anagnostoug/EcoFarmBot/final_main_photo.jpg

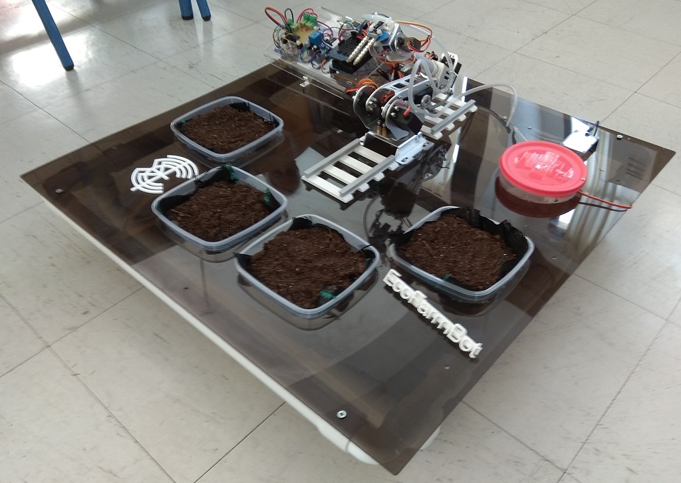
final_main_photo.jpg
