anagnostoug/EcoFarmBot/final_photo_2.jpg

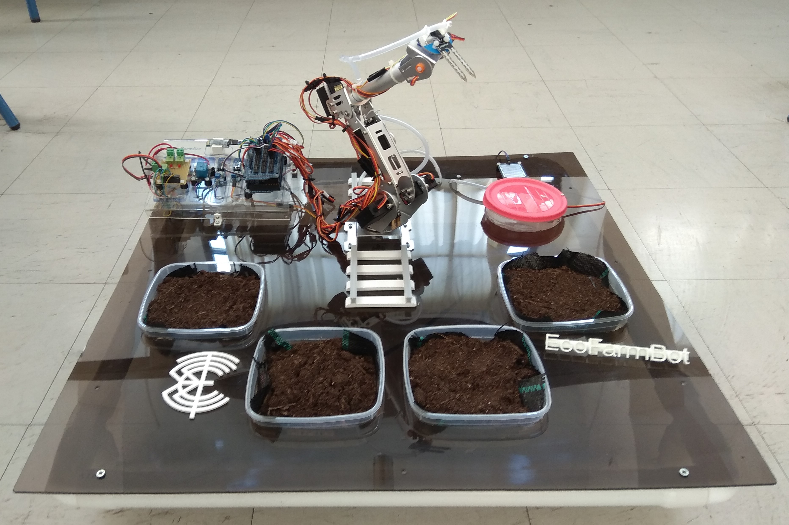
final_photo_2.jpg
