anagnostoug/EcoFarmBot/Φύλλα Έργου/5ο ΦΥΛΛΟ ΕΡΓΟΥ - ΣΥΝΔΕΣΜΟΛΟΓΙΑ.docx

ECO FARM BOT

5ο Φύλλο Έργου - ΣΥΝΔΕΣΜΟΛΟΓΙΑ

Για τη κατασκευή χρησιμοποιούνται τα παρακάτω εξαρτήματα και module:

Α/Α | ΟΝΟΜΑΣΙΑ | ΕΙΚΟΝΑ

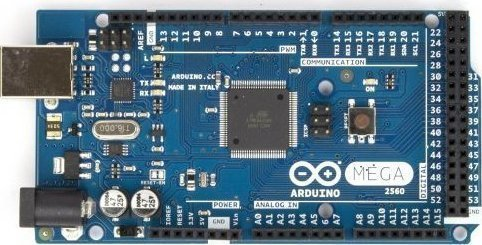
[picture p7: figure]
20150812135726_arduino_mega_2560_rev3

1 | Arduino Mega

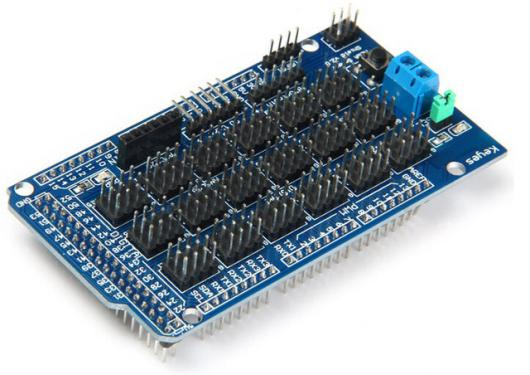
[picture p8: figure]
MEGA-Sensor-Shield-V2-0-Expansion-Board-For-Arduino-ATMEGA-2560-R3

2 | Arduino Mega Shield

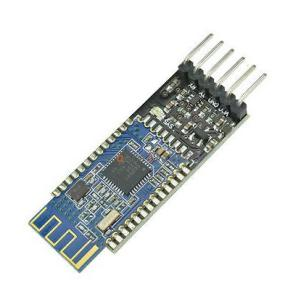
[picture p9: figure]
hm-10-ble-bluetooth-40-cc2540-cc2541-serial-wireless-module-arduino-android-ios

3 | Arduino Bluetooth

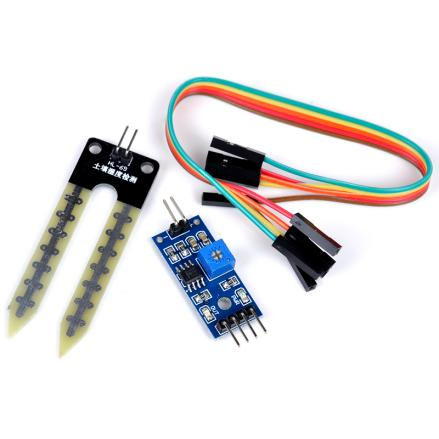
[picture p10: figure]
Hot-Sale-LM393-3-3-5V-Soil-Hygrometer-Detection-Module-Soil-Moisture-Water-Sensor-for-Arduino

4 | Arduino Soil Sensor

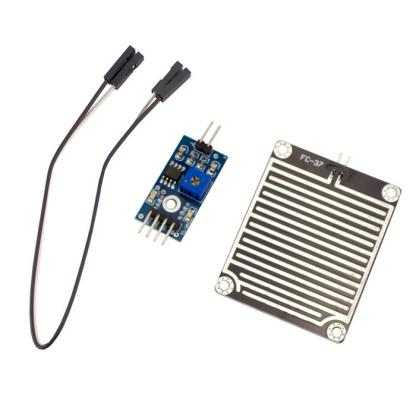
[picture p11: figure]
sku_266534_1

5 | Arduino Rain Sensor

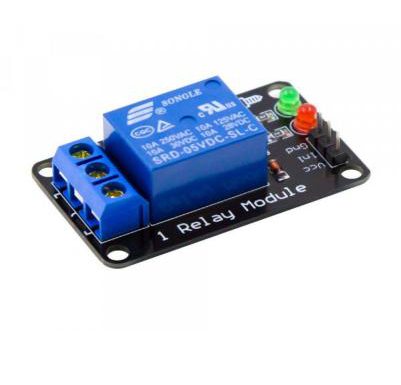
[picture p12: figure]
Relay module 1Channel 5V-600x800

6 | Arduino Relay

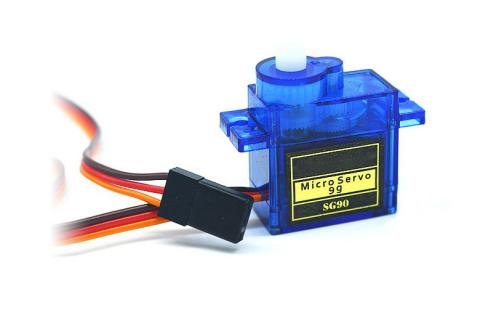
[picture p13: figure]
SG90-micro-9g-servo-for-Rc-Helicopter

7 | Arduino Servo Motor

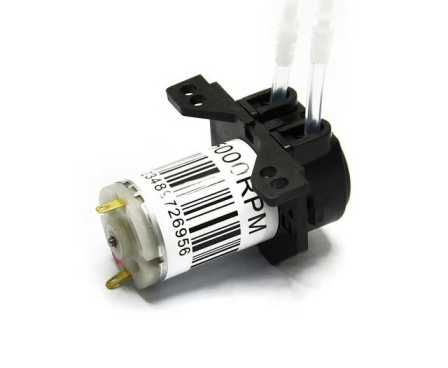
[picture p14: figure]
12V-24V-DC-Dosing-Pump-Peristaltic-pump-Dosing-Head-with-Connector-For-Arduino-Aquarium-Lab-Analytic.jpg_640x640

8 | Peristaltic Pump

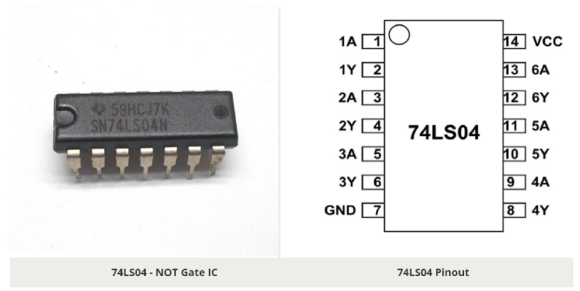
[picture p15: figure]
74ls04

9 | NOT Gate

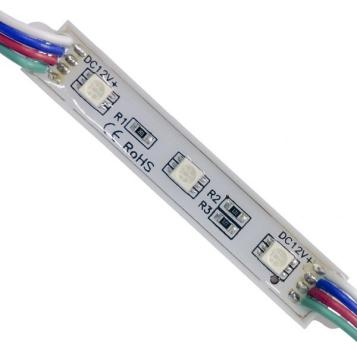
[picture p16: figure]
55563e_globostar_led_module_5050_smd_rgb

10 | RGB Led Strip

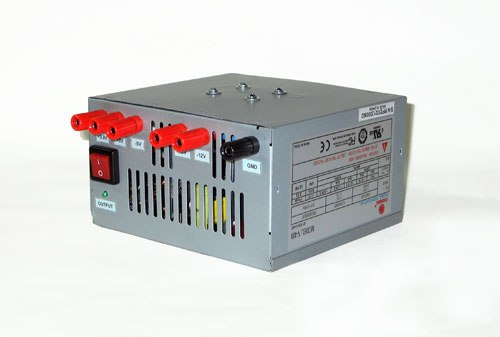
[picture p17: figure]
power-supply-3-500

11 | PC Power Supply

Η συνδεσμολογία γίνεται βάση του παρακάτω αναλυτικού σχεδίου.

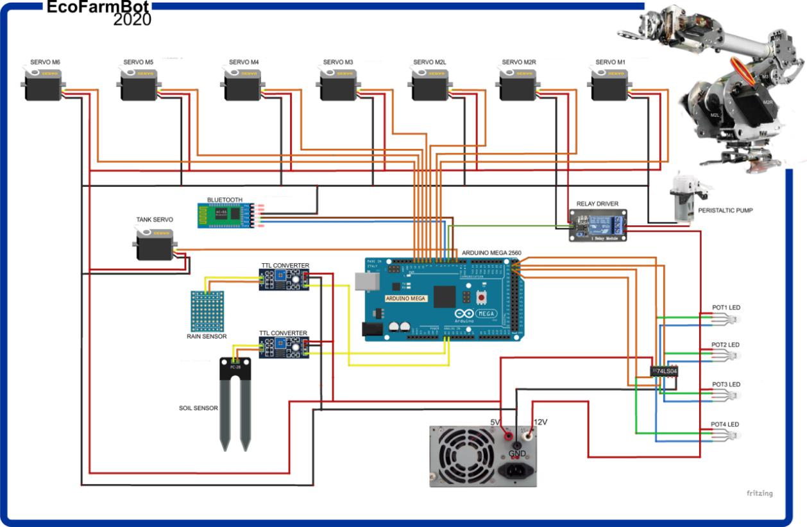
[picture p18: figure]
plan1

Στη σελίδα https://github.com/anagnostoug/ecofarmbot θα βρείτε όλα τα φύλλα έργου της κατασκευής, το παραπάνω σχέδιο σε μεγαλύτερη εικόνα καθώς επίσης και τους κώδικες για τον έλεγχο του βραχίονα αλλά και της εφαρμογής που εμφανίζει τις απαραίτητες πληροφορίες στο κινητό μας τηλέφωνο.

ΣΙΒΙΤΑΝΙΔΕΙΟΣ ΔΗΜΟΣΙΑ ΣΧΟΛΗ 2ο ΕΠΑΛ ΤΕΧΝΩΝ ΚΑΙ ΕΠΑΓΓΕΛΜΑΤΩΝ ΤΜΗΜΑ ΗΛΕΚΤΡΟΝΙΚΩΝ
