anagnostoug/EcoFarmBot/Φύλλα Έργου/1ο ΦΥΛΛΟ ΕΡΓΟΥ - ΣΚΕΛΕΤΟΣ.docx

ECO FARM BOT

1ο Φύλλο Έργου - Σκελετός

Ο σκελετός της κατασκευής θα υλοποιηθεί με σωλήνες νερού Φ.30, ώστε η συναρμολόγηση να είναι εύκολη και επεκτάσιμη. Χρησιμοποιούμε τα παρακάτω στελέχη:

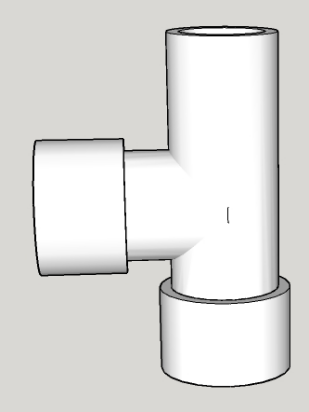
[picture p19: figure]
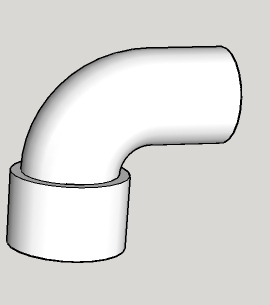
[picture p20: figure]
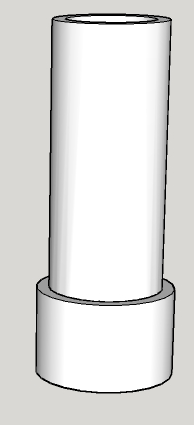
[picture p21: figure]
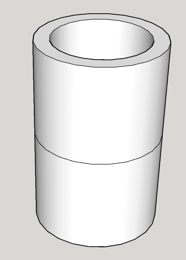
[picture p22: figure]

ΤΑΥ | Γωνία 90ο | Ευθεία σωλήνα | Μούφα

Η κατασκευή θα έχει σχήμα ορθογωνίου παραλληλεπιπέδου, ώστε να υπάρχει σωστή στήριξη των επιμέρους υλικών αλλά και χώρος για την τοποθέτησή τους.

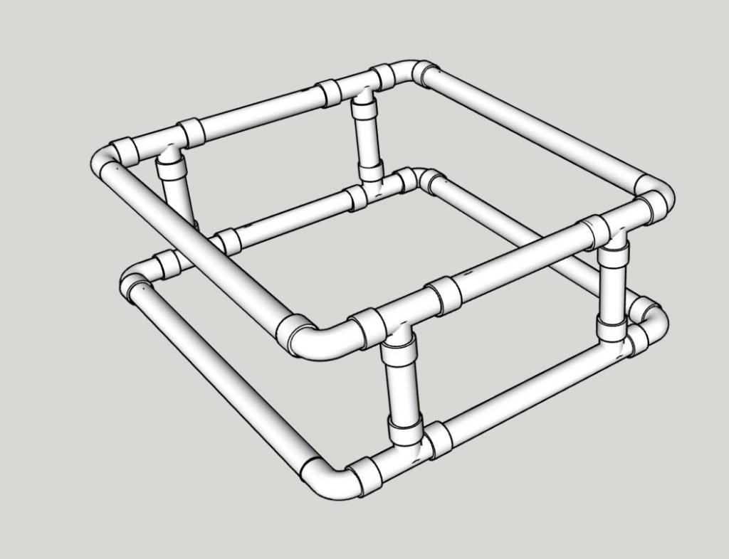
[picture p23: figure]
skeletos

ΣΙΒΙΤΑΝΙΔΕΙΟΣ ΔΗΜΟΣΙΑ ΣΧΟΛΗ 2ο ΕΠΑΛ ΤΕΧΝΩΝ ΚΑΙ ΕΠΑΓΓΕΛΜΑΤΩΝ ΤΜΗΜΑ ΗΛΕΚΤΡΟΝΙΚΩΝ
