anagnostoug/EcoFarmBot/Φύλλα Έργου/4ο ΦΥΛΛΟ ΕΡΓΟΥ - ΚΑΤΑΣΚΕΥΗ.docx

ECO FARM BOT

4ο Φύλλο Έργου - ΚΑΤΑΣΚΕΥΗ

Αφού έχουν ολοκληρωθεί τα παραπάνω βήματα, τοποθετούμε τις γλάστρες και τη δεξαμενή νερού πάνω στο plexiglass.

Στη συνέχεια δημιουργούμε τις σωληνώσεις από τις γλάστρες προς τη δεξαμενή, ώστε να συγκεντρώνει το νερό που φεύγει από κάθε γλάστρα.

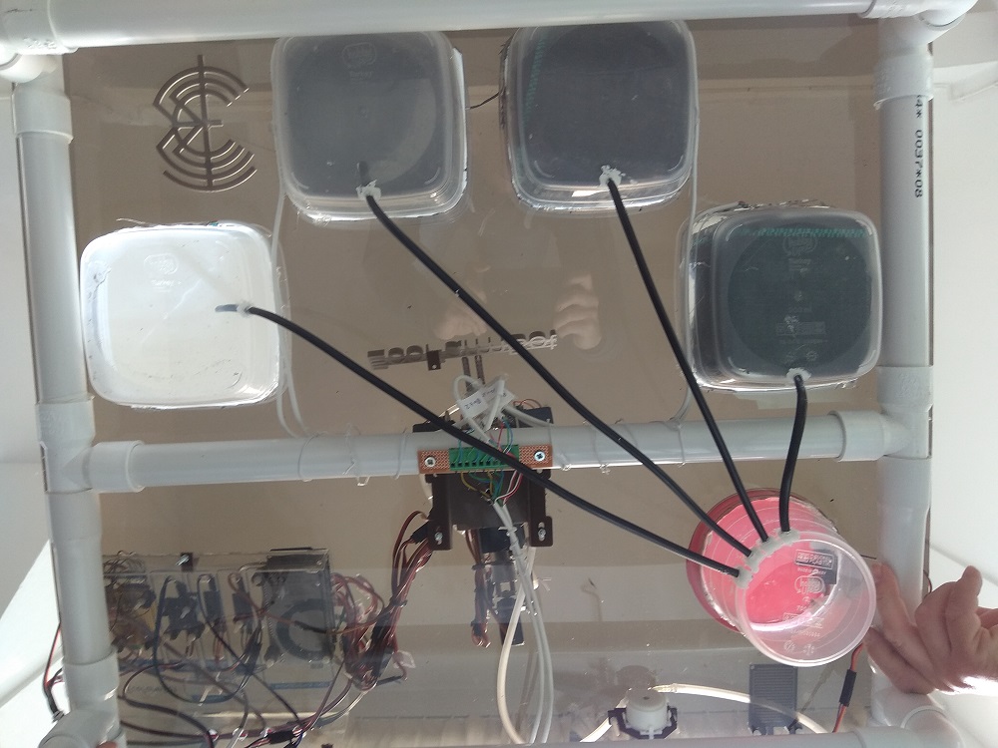
[picture p24: figure]
glastres

Ο βραχίονας βιδώνεται πάνω στο plexiglass σε τέτοια θέση ώστε να μπορεί να προσεγγίσει όλες τις γλάστρες.

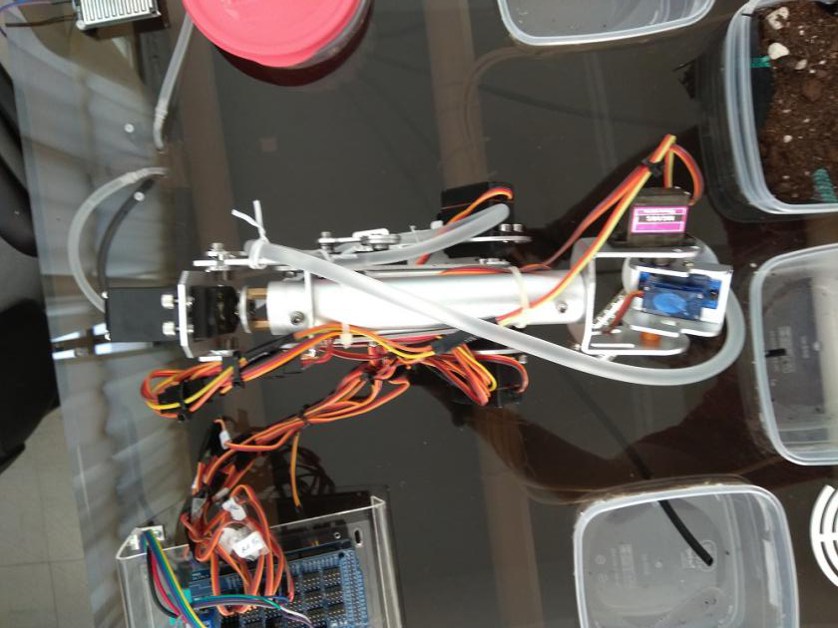
[picture p25: figure]
arm1

Για τη τοποθέτηση των κυκλωμάτων ελέγχου χρησιμοποιούμε ένα Plexiglass που σταθεροποιείται πάνω στην κατασκευή. Εκτυπώνουμε σε διαφάνεια τη θέση των πλακετών και μετά τα τοποθετούμε όλα μαζί όπως φαίνεται παρακάτω.

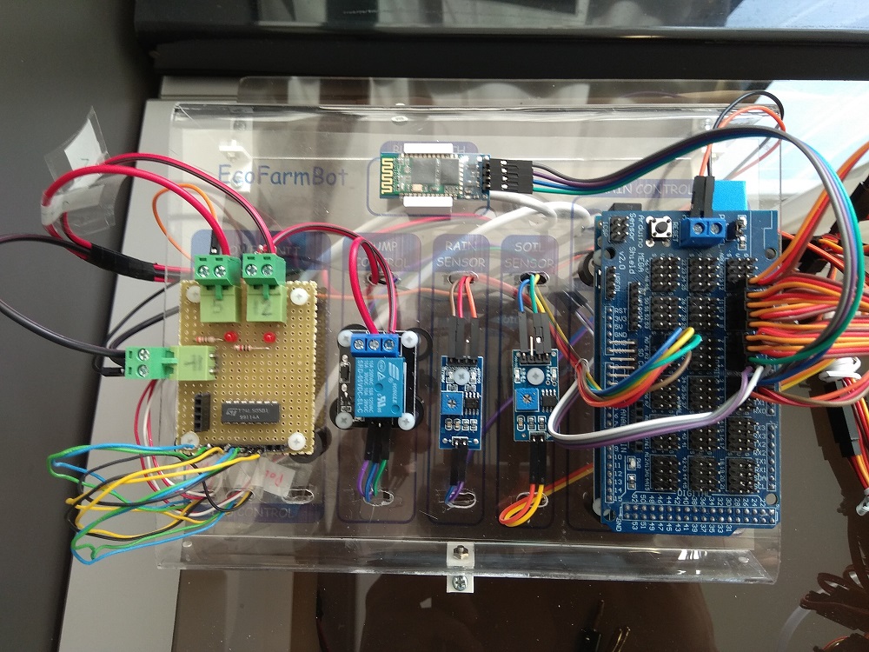
[picture p26: figure]
plakat

Η δεξαμενή έχει ένα καπάκι που ελέγχεται από servo motor μαζί με τον αισθητήρα βροχής. Κάθε φορά που βρέχει, το καπάκι ανοίγει για τη συλλογή του βρόχινου νερού.

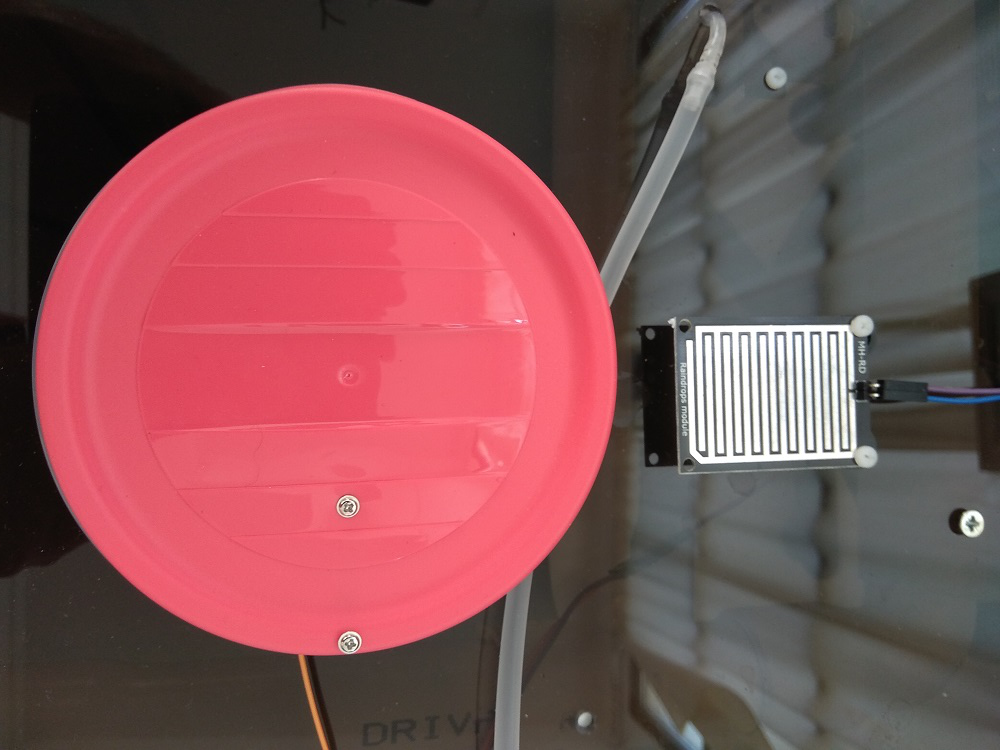
[picture p27: figure]
dexameni

Στην κορυφή του βραχίονα τοποθετείται αισθητήρας υγρασίας χώματος για τη μέτρηση που θέλουμε και επίσης σωλήνας νερού για το πότισμα, οποίος τροφοδοτείται από τη δεξαμενή νερού μέσω μιας δοσομετρικής αντλίας.

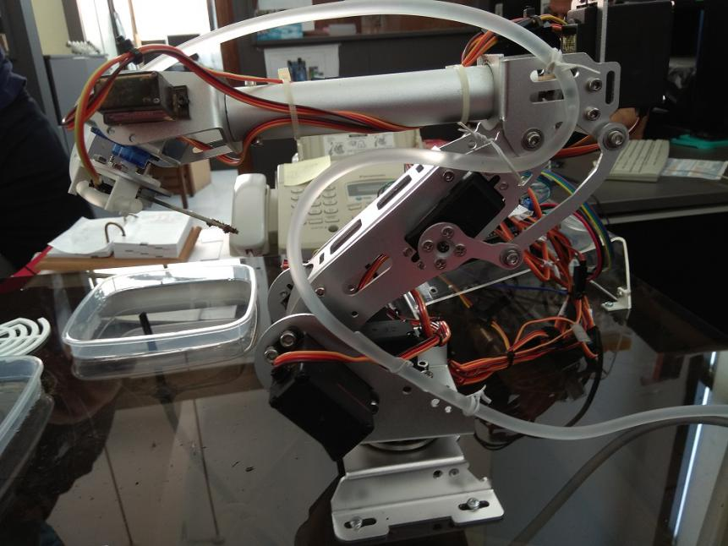
[picture p28: figure]
arm2

Μπροστά από κάθε γλάστρα τοποθετούνται LED που αλλάζουν χρώμα ανάλογα με την υγρασία του χώματος.

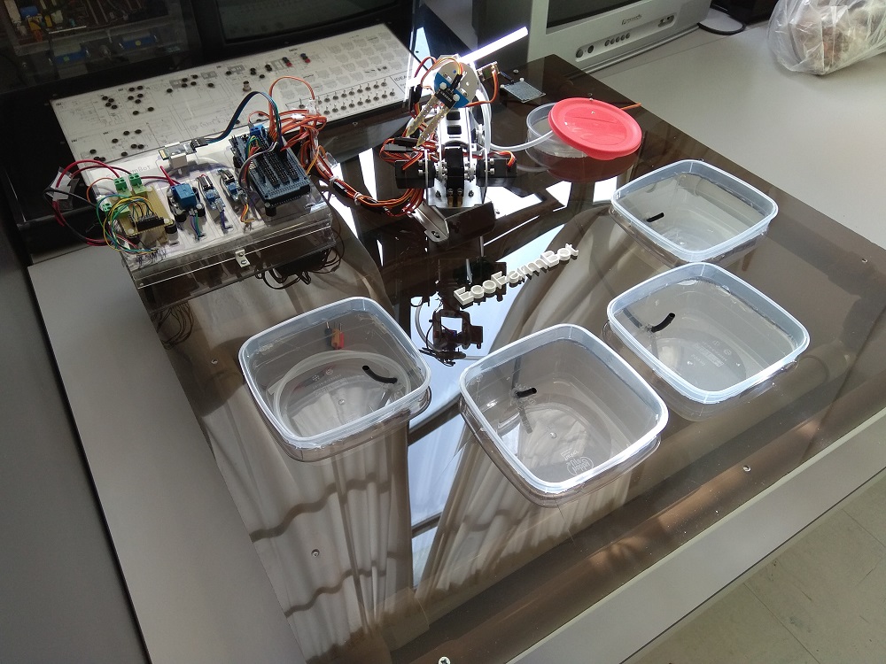
[picture p29: figure]
final1

ΣΙΒΙΤΑΝΙΔΕΙΟΣ ΔΗΜΟΣΙΑ ΣΧΟΛΗ 2ο ΕΠΑΛ ΤΕΧΝΩΝ ΚΑΙ ΕΠΑΓΓΕΛΜΑΤΩΝ ΤΜΗΜΑ ΗΛΕΚΤΡΟΝΙΚΩΝ
