anagnostoug/EcoFarmBot/plan.jpg

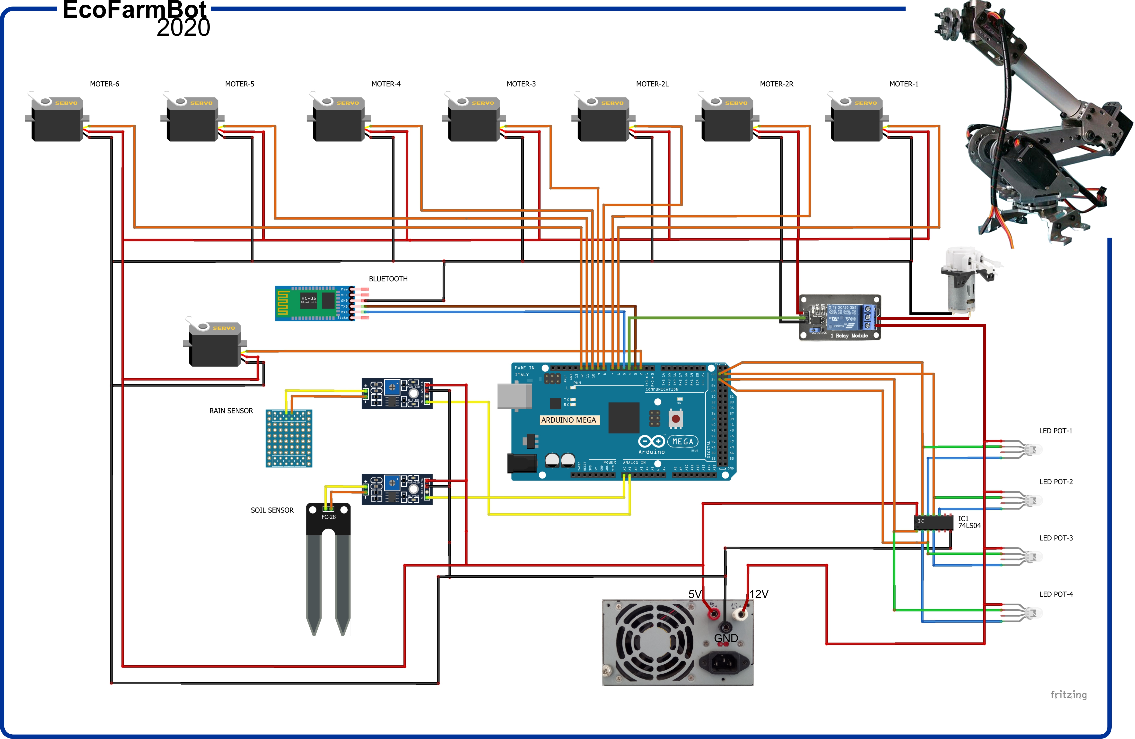
plan.jpg
